distinctm1nd/cthulu_minibadge_holder/hardware/cthulu_minibadge_holder.kicad_pcb

## KiCad design hardware/cthulu_minibadge_holder.kicad_pcb (2026-10-22)

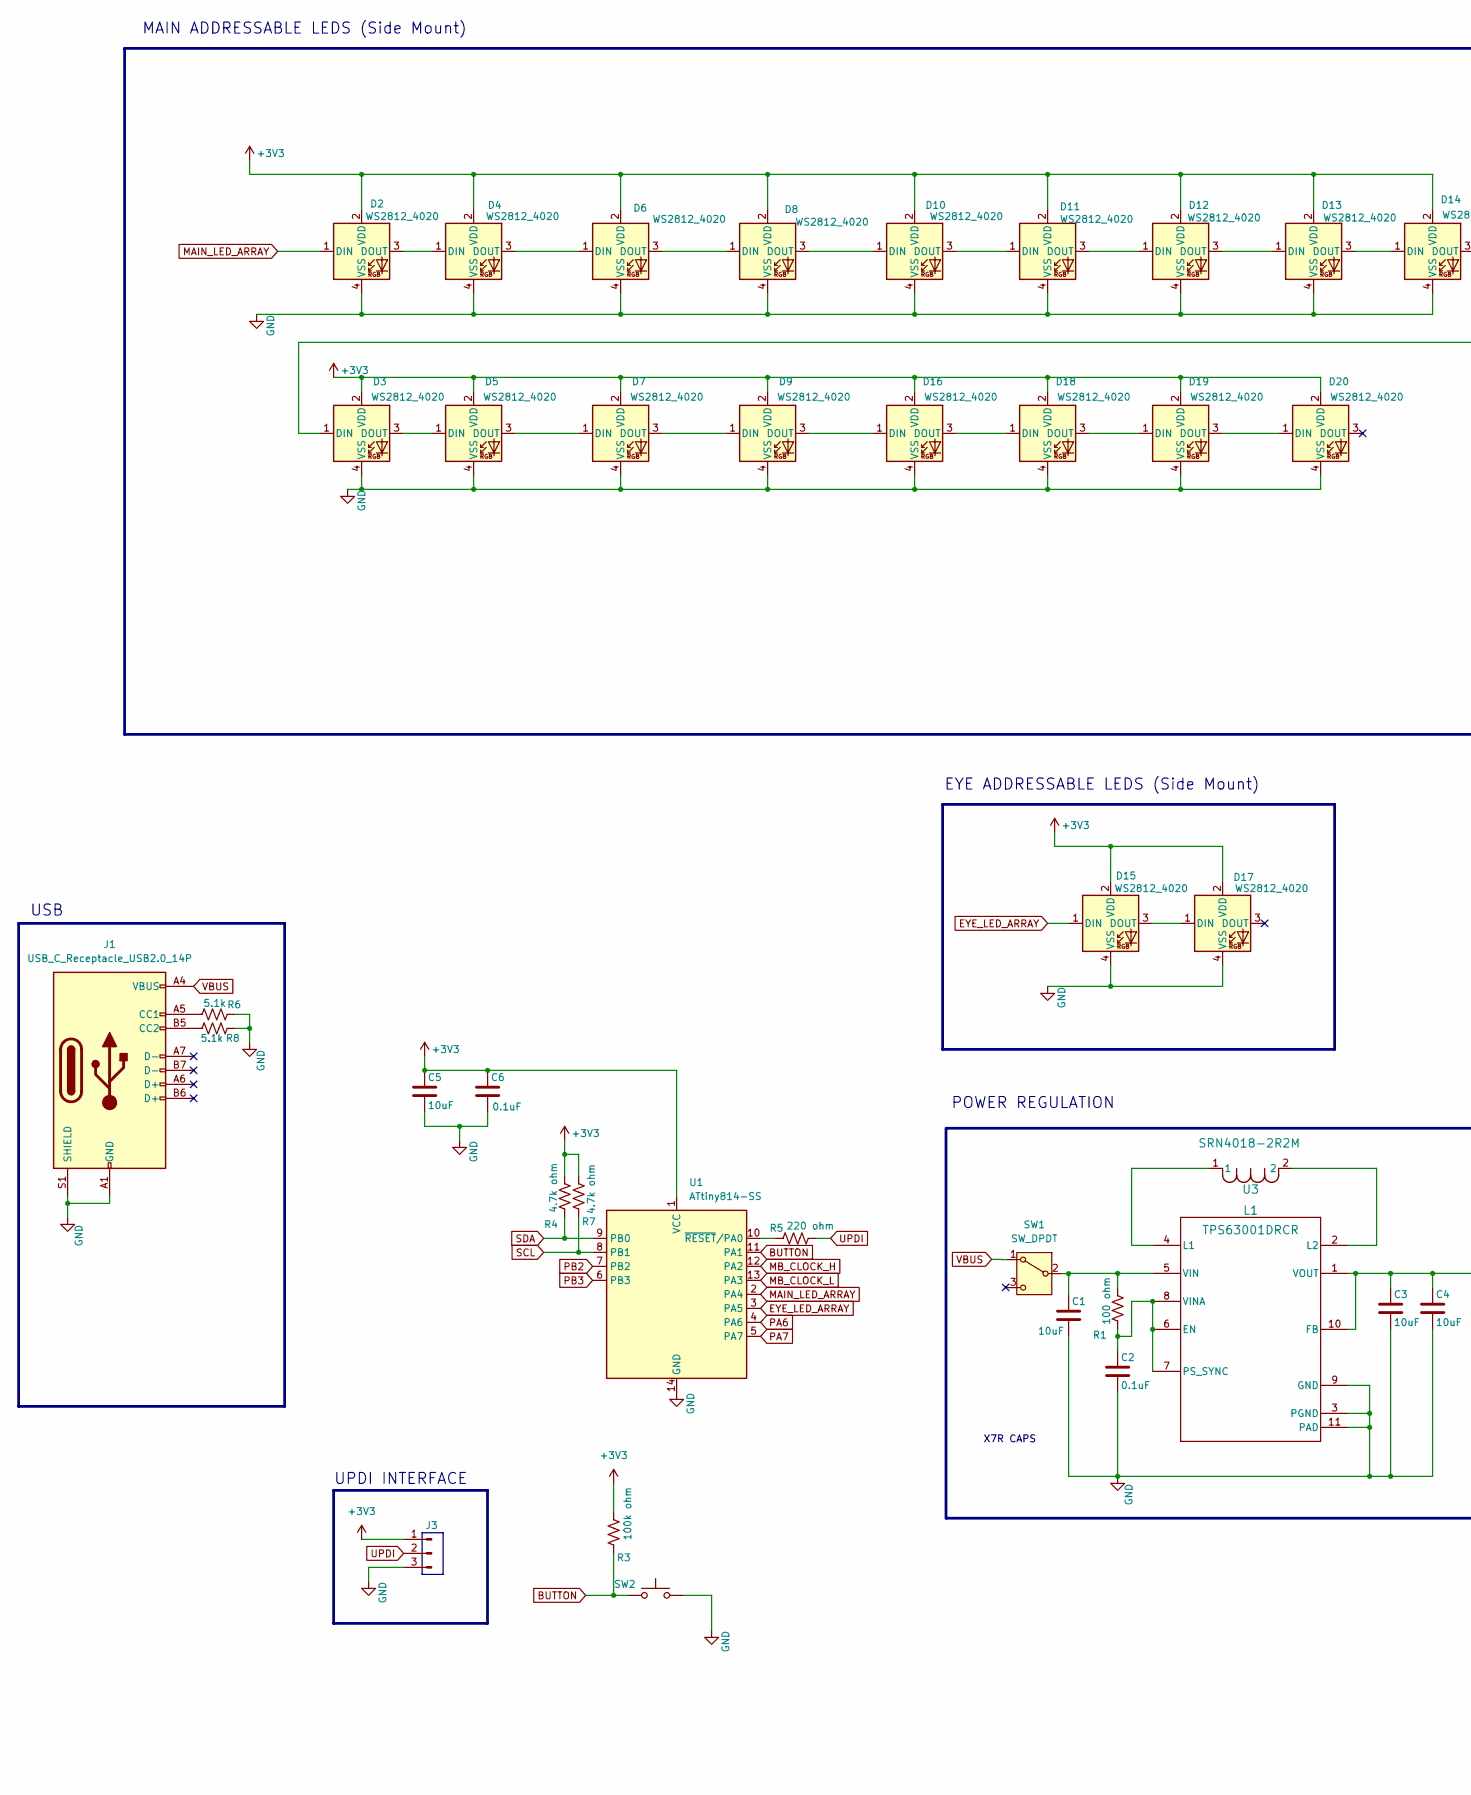
[picture p2: schematic cthulu_minibadge_holder.kicad_sch, part in row 1, column 1]

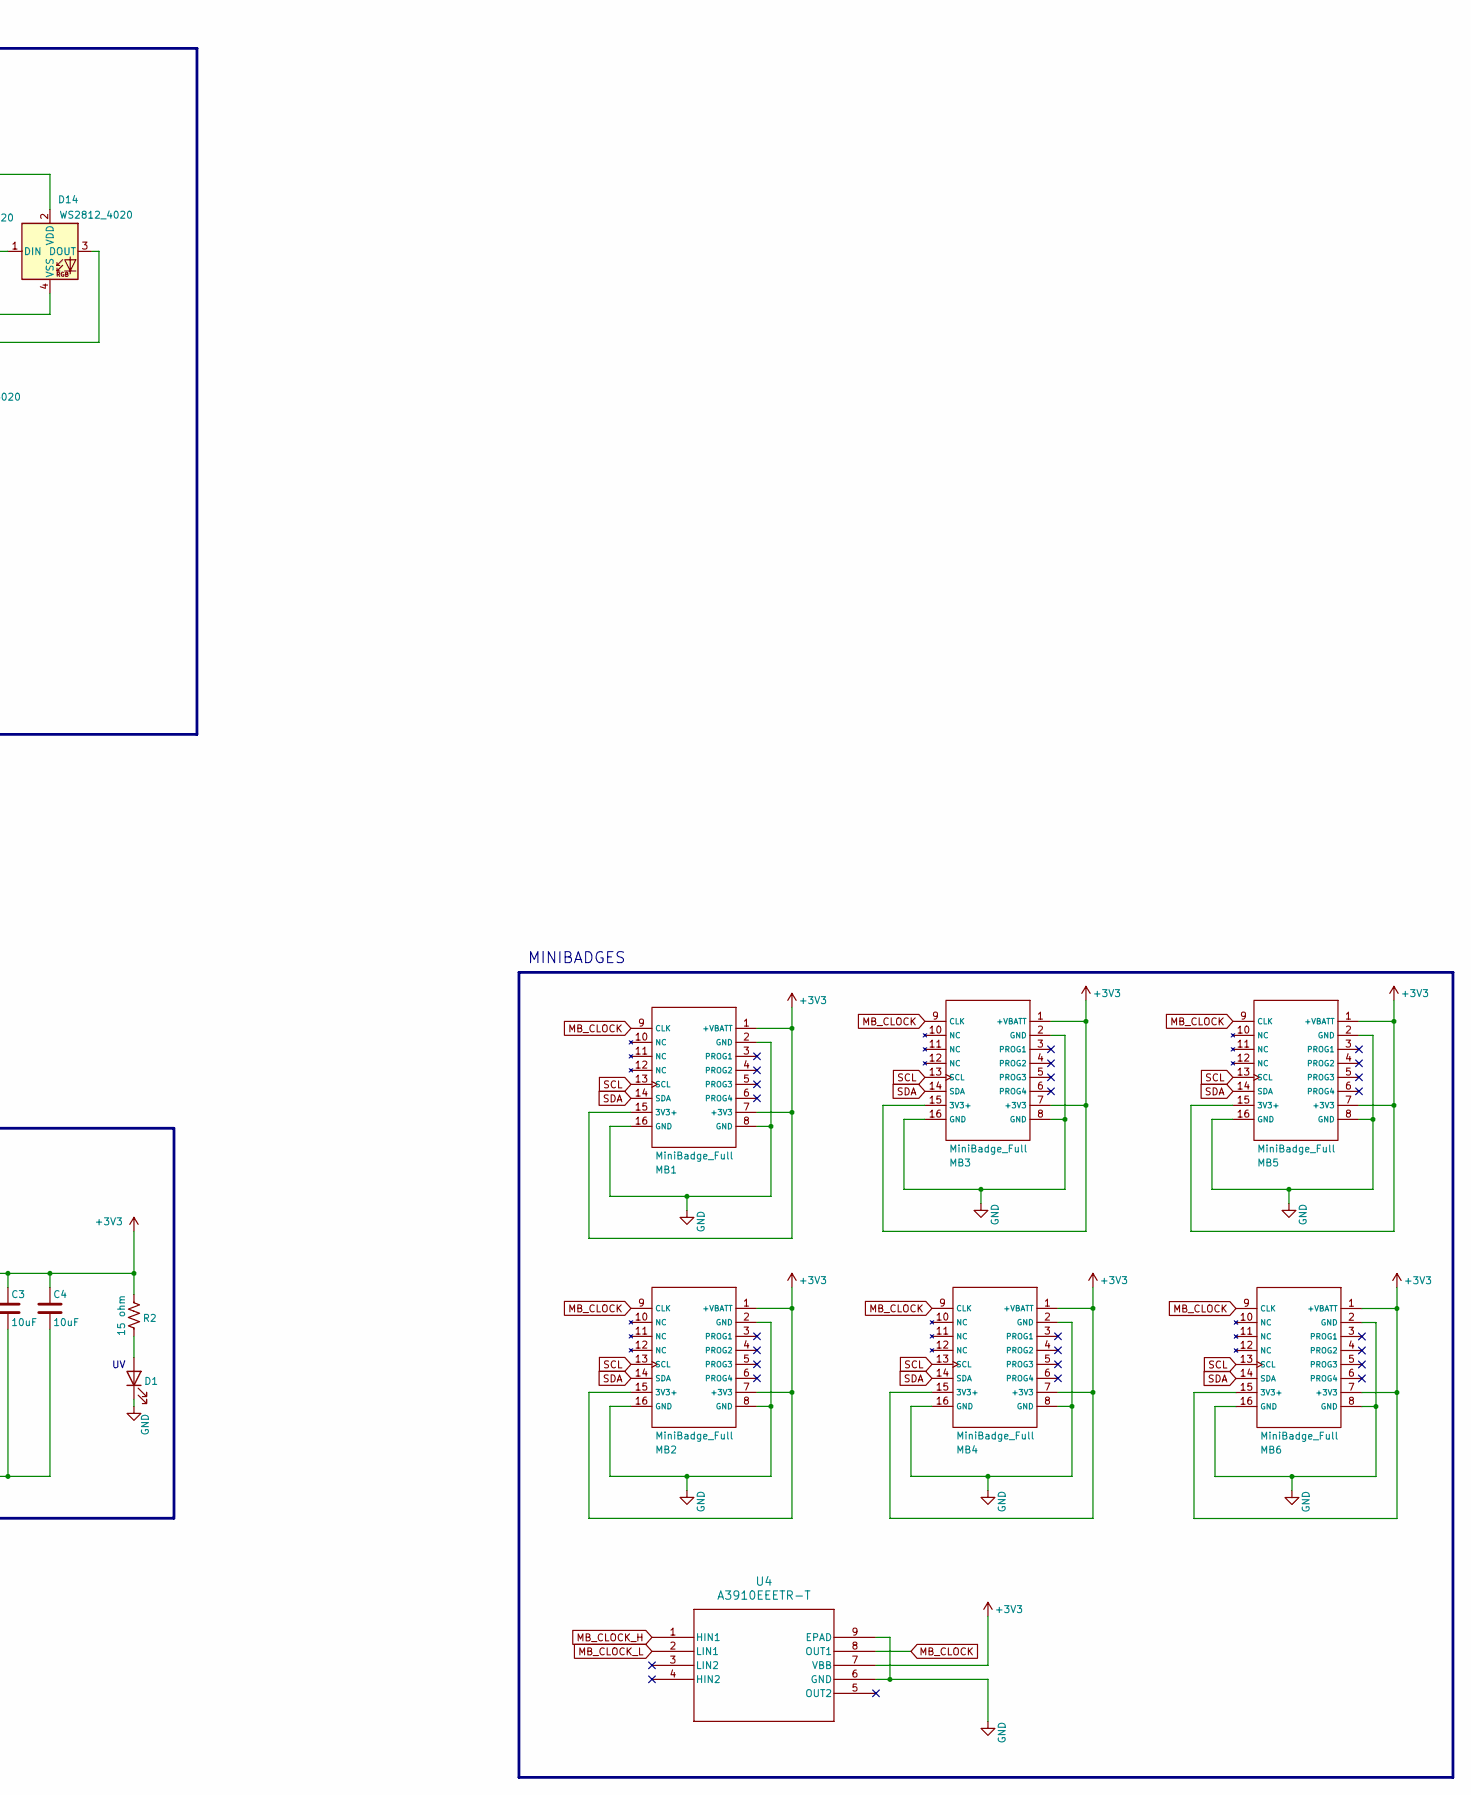
[picture p3: schematic cthulu_minibadge_holder.kicad_sch, part in row 1, column 2]

Parts:
C1, C3, C4, C5: 10uF; C_0805_2012Metric_Pad1.18x1.45mm_HandSolder
C2, C6: 0.1uF; C_0603_1608Metric_Pad1.08x0.95mm_HandSolder
D1: LED; LED_1206_3216Metric_Pad1.42x1.75mm_HandSolder
D2, D3, D4, D5, D6, D7, D8, D9, D10, D11, D12, D13, D14, D15, D16, D17, D18, D19, D20: WS2812_4020; sk6812-side-a
J1: USB_C_Receptacle_USB2.0_14P; USB_C_Receptacle_GCT_USB4125-xx-x-0190_6P_TopMnt_Horizontal
J3: Conn_01x03_Pin; night_evil_ai_updi
L1: SRN4018-2R2M; L_Bourns-SRN4018
MB1, MB2, MB3, MB4, MB5, MB6: MiniBadge_Full; MiniBadge_Slot_Basic
R1: 100 ohm; R_0603_1608Metric_Pad0.98x0.95mm_HandSolder
R2: 15 ohm; R_0603_1608Metric_Pad0.98x0.95mm_HandSolder
R3: 100k ohm; R_0603_1608Metric_Pad0.98x0.95mm_HandSolder
R4, R7: 4.7k ohm; R_0603_1608Metric_Pad0.98x0.95mm_HandSolder
R5: 220 ohm; R_0603_1608Metric_Pad0.98x0.95mm_HandSolder
R6, R8: 5.1k; R_0603_1608Metric_Pad0.98x0.95mm_HandSolder
SW1: SW_DPDT; js202011jaqn
SW2: SW_Push; button_switch_TL3305A
U1: ATtiny814-SS; SOIC-14_3.9x8.7mm_P1.27mm
U3: TPS63001DRCR; Texas_DRC0010J
U4: A3910EEETR-T; DFN-8_ALM

Connections:
+3V3: C3.1, C4.1, C5.1, C6.1, D2.2 (VDD), D3.2 (VDD), D4.2 (VDD), D5.2 (VDD), D6.2 (VDD), D7.2 (VDD), D8.2 (VDD), D9.2 (VDD), D10.2 (VDD), D11.2 (VDD), D12.2 (VDD), D13.2 (VDD), D14.2 (VDD), D15.2 (VDD), D16.2 (VDD), D17.2 (VDD), D18.2 (VDD), D19.2 (VDD), D20.2 (VDD), J3.1, MB1.1 (+VBATT), MB1.7 (+3V3), MB1.15 (3V3+), MB2.1 (+VBATT), MB2.7 (+3V3), MB2.15 (3V3+), MB3.1 (+VBATT), MB3.7 (+3V3), MB3.15 (3V3+), MB4.1 (+VBATT), MB4.7 (+3V3), MB4.15 (3V3+), MB5.1 (+VBATT), MB5.7 (+3V3), MB5.15 (3V3+), MB6.1 (+VBATT), MB6.7 (+3V3), MB6.15 (3V3+), R2.1, R3.1, R4.1, R7.1, U1.1 (VCC), U3.1 (VOUT), U3.10 (FB), U4.7 (VBB)
BUTTON: R3.2, SW2.1, U1.11 (PA1)
EYE_LED_ARRAY: D15.1 (DIN), U1.3 (PA5)
GND: C1.2, C2.2, C3.2, C4.2, C5.2, C6.2, D1.1 (K), D2.4 (VSS), D3.4 (VSS), D4.4 (VSS), D5.4 (VSS), D6.4 (VSS), D7.4 (VSS), D8.4 (VSS), D9.4 (VSS), D10.4 (VSS), D11.4 (VSS), D12.4 (VSS), D13.4 (VSS), D14.4 (VSS), D15.4 (VSS), D16.4 (VSS), D17.4 (VSS), D18.4 (VSS), D19.4 (VSS), D20.4 (VSS), J1.A1 (GND), J1.A12 (GND), J1.B1 (GND), J1.B12 (GND), J1.S1 (SHIELD), J3.3, MB1.2 (GND), MB1.8 (GND), MB1.16 (GND), MB2.2 (GND), MB2.8 (GND), MB2.16 (GND), MB3.2 (GND), MB3.8 (GND), MB3.16 (GND), MB4.2 (GND), MB4.8 (GND), MB4.16 (GND), MB5.2 (GND), MB5.8 (GND), MB5.16 (GND), MB6.2 (GND), MB6.8 (GND), MB6.16 (GND), R6.1, R8.1, SW2.2, U1.14 (GND), U3.3 (PGND), U3.9 (GND), U3.11 (PAD), U4.6 (GND), U4.9 (EPAD)
MAIN_LED_ARRAY: D2.1 (DIN), U1.2 (PA4)
MB_CLOCK: MB1.9 (CLK), MB2.9 (CLK), MB3.9 (CLK), MB4.9 (CLK), MB5.9 (CLK), MB6.9 (CLK), U4.8 (OUT1)
MB_CLOCK_H: U1.12 (PA2), U4.1 (HIN1)
MB_CLOCK_L: U1.13 (PA3), U4.2 (LIN1)
unnamed: D1.2 (A), R2.2
unnamed: D2.3 (DOUT), D4.1 (DIN)
unnamed: D3.3 (DOUT), D5.1 (DIN)
unnamed: D4.3 (DOUT), D6.1 (DIN)
unnamed: D5.3 (DOUT), D7.1 (DIN)
unnamed: D6.3 (DOUT), D8.1 (DIN)
unnamed: D7.3 (DOUT), D9.1 (DIN)
unnamed: D8.3 (DOUT), D10.1 (DIN)
unnamed: D10.3 (DOUT), D11.1 (DIN)
unnamed: D11.3 (DOUT), D12.1 (DIN)
unnamed: D12.3 (DOUT), D13.1 (DIN)
unnamed: D13.3 (DOUT), D14.1 (DIN)
unnamed: D3.1 (DIN), D14.3 (DOUT)
unnamed: D15.3 (DOUT), D17.1 (DIN)
unnamed: D9.3 (DOUT), D16.1 (DIN)
unnamed: D16.3 (DOUT), D18.1 (DIN)
unnamed: D18.3 (DOUT), D19.1 (DIN)
unnamed: D19.3 (DOUT), D20.1 (DIN)
unnamed: J1.A5 (CC1), R6.2
unnamed: J1.B5 (CC2), R8.2
unnamed: C1.1, R1.1, SW1.2 (B), U3.5 (VIN)
unnamed: R5.2, U1.10 (~RESET/PA0)
unnamed: C2.1, R1.2, U3.6 (EN), U3.7 (PS_SYNC), U3.8 (VINA)
unnamed: L1.1, U3.4 (L1)
unnamed: L1.2, U3.2 (L2)
PA6: U1.4 (PA6)
PA7: U1.5 (PA7)
PB2: U1.7 (PB2)
PB3: U1.6 (PB3)
SCL: MB1.13 (SCL), MB2.13 (SCL), MB3.13 (SCL), MB4.13 (SCL), MB5.13 (SCL), MB6.13 (SCL), R7.2, U1.8 (PB1)
SDA: MB1.14 (SDA), MB2.14 (SDA), MB3.14 (SDA), MB4.14 (SDA), MB5.14 (SDA), MB6.14 (SDA), R4.2, U1.9 (PB0)
UPDI: J3.2, R5.1
VBUS: J1.A4 (VBUS), J1.A9 (VBUS), J1.B4 (VBUS), J1.B9 (VBUS), SW1.1 (A)

Notes on the sheet:
UPDI INTERFACE
POWER REGULATION
MINIBADGES
X7R CAPS
MAIN ADDRESSABLE LEDS (Side Mount)
EYE ADDRESSABLE LEDS (Side Mount)
USB

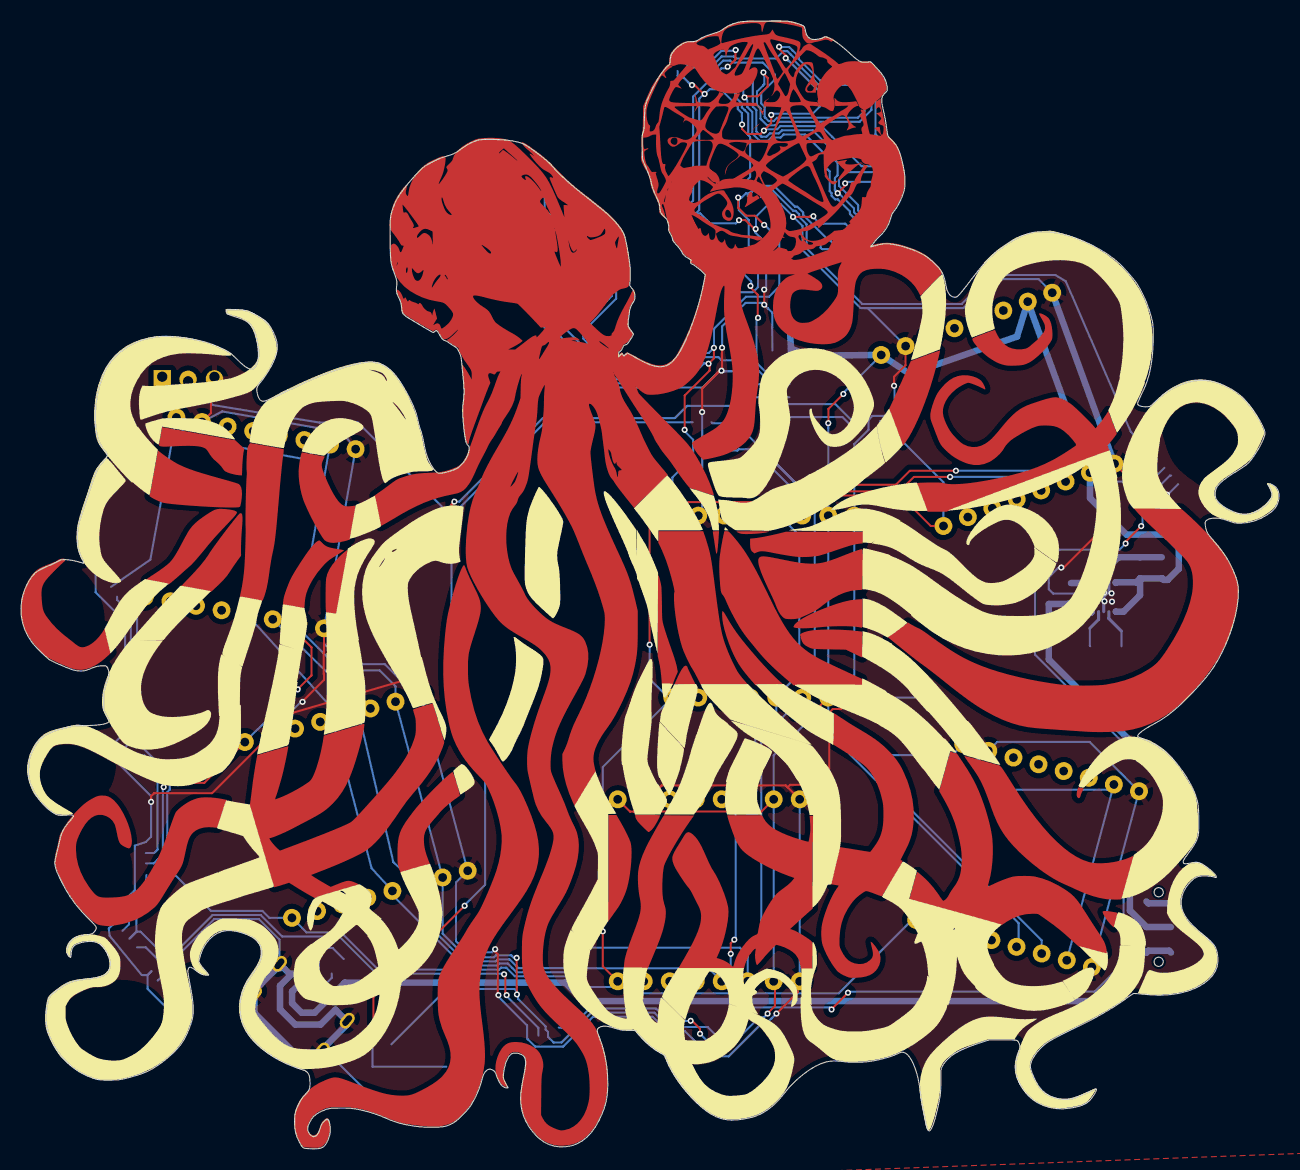
[picture p4: board cthulu_minibadge_holder.kicad_pcb from above]

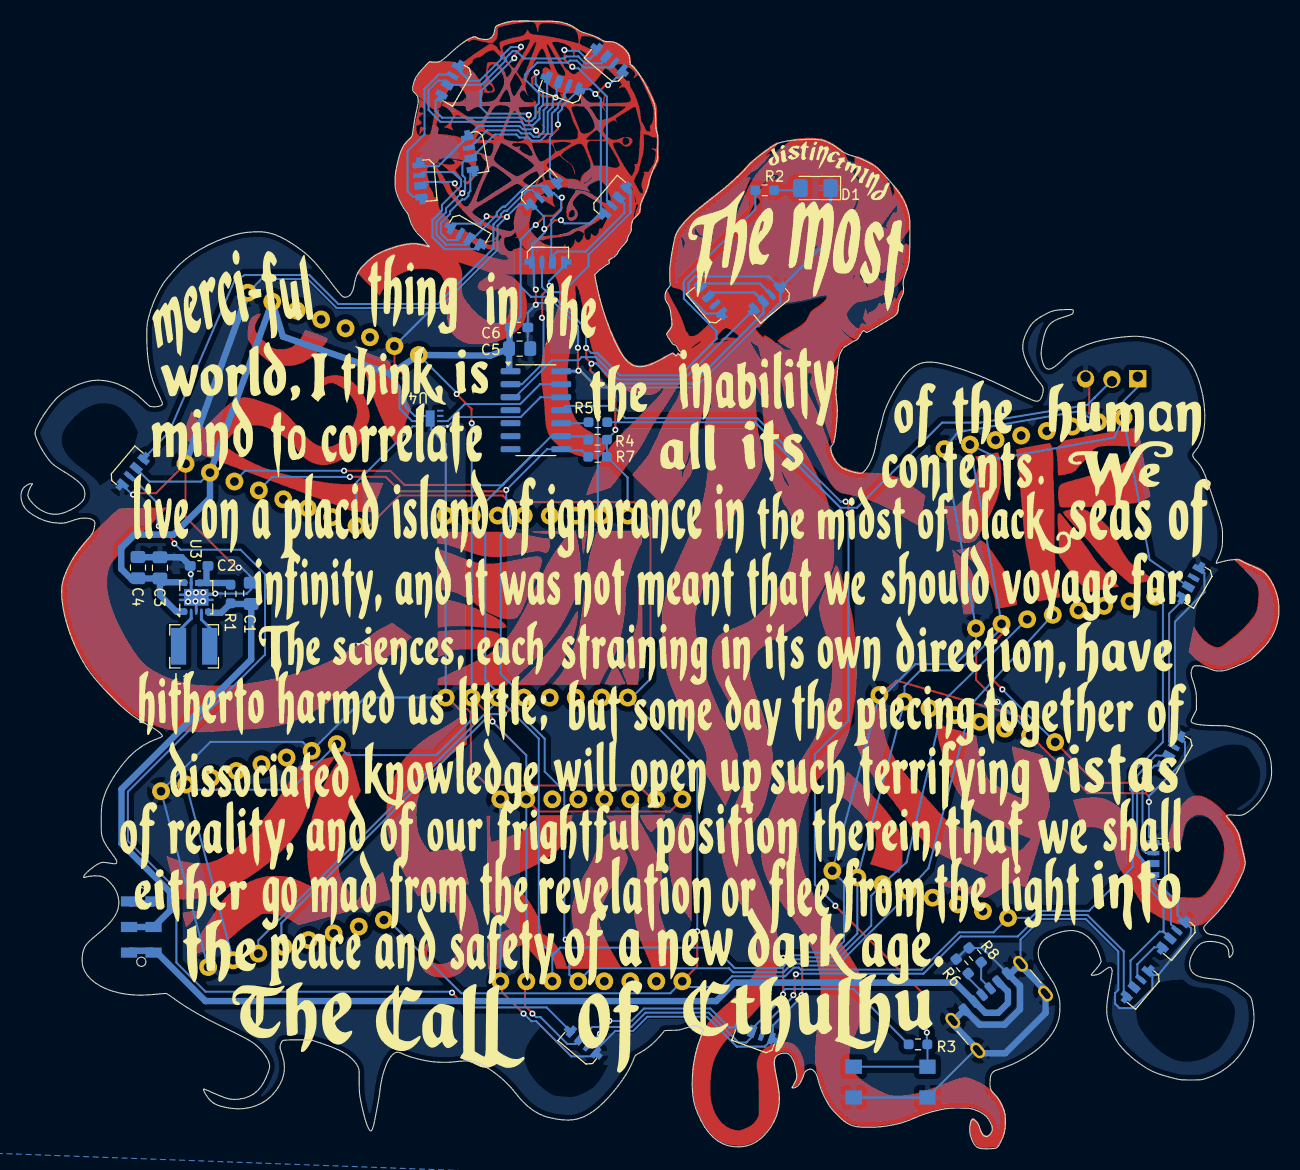
[picture p5: board cthulu_minibadge_holder.kicad_pcb from below]

Board: 2 copper layers, 122.9 x 110.2 mm, 48 parts (42 on the bottom side), 37 nets.
